galopago/compact-nfc/compact-nfc.kicad_pcb

## KiCad design compact-nfc.kicad_pcb (2026-01-25)

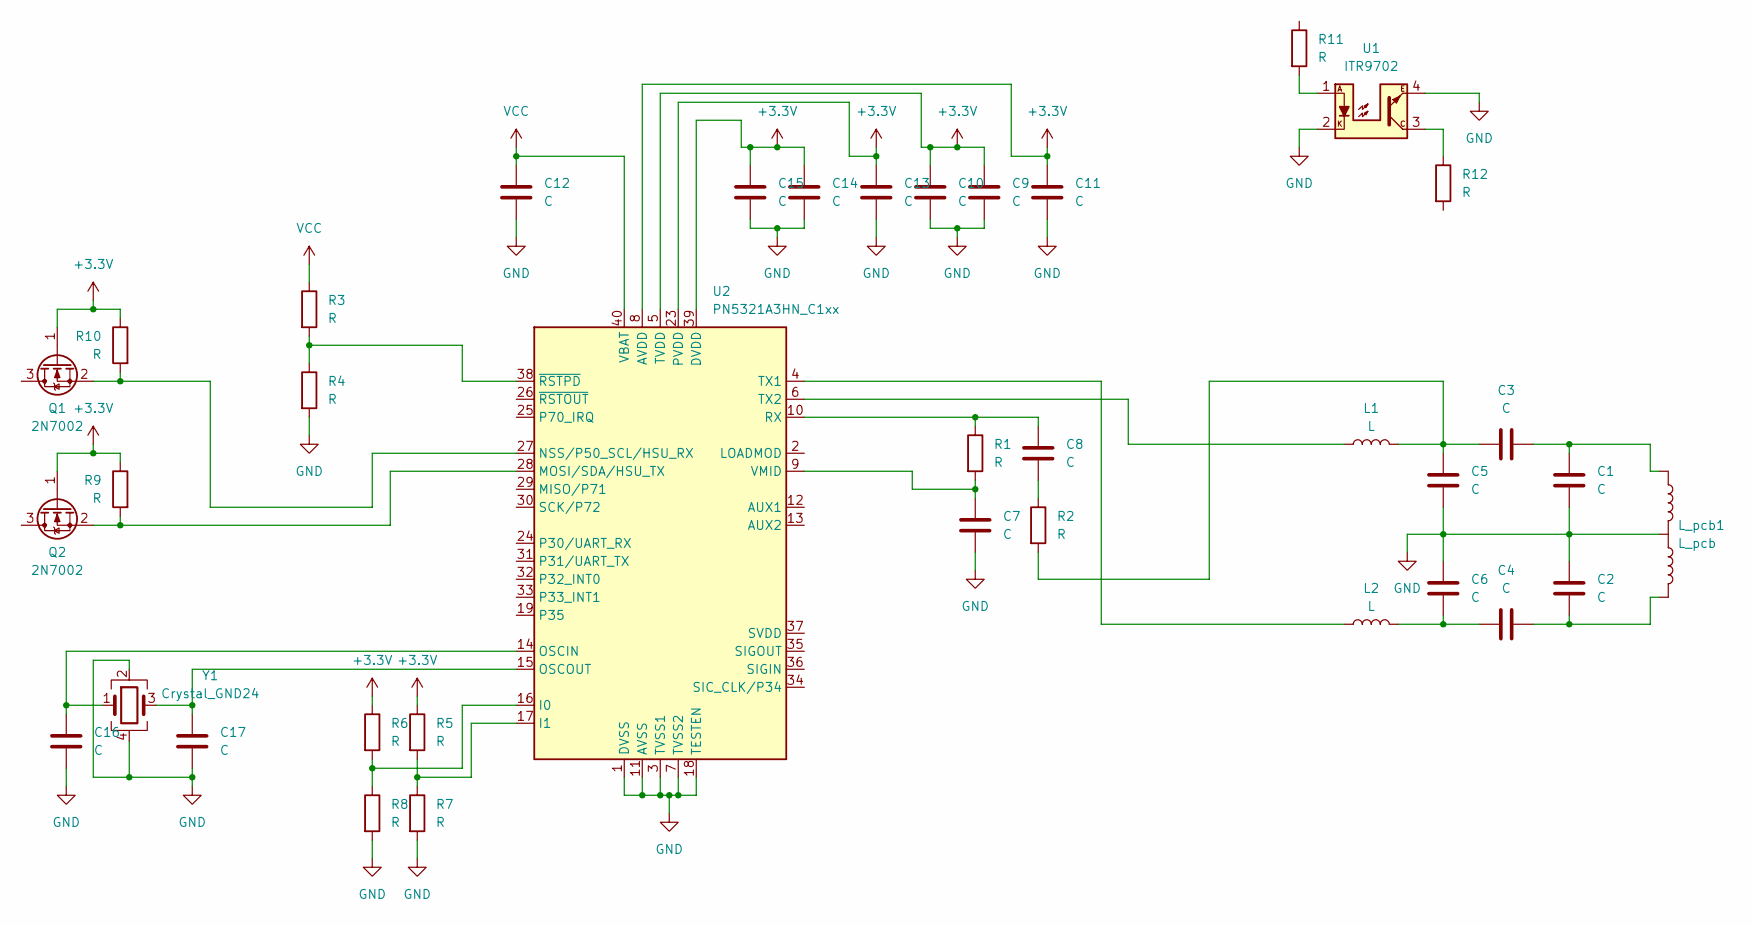
[picture p12: schematic compact-nfc.kicad_sch]

Parts:
C1, C2, C3, C4, C5, C6, C7, C8, C9, C10, C11, C12, C13, C14, C15, C16, C17: C; C_0805_2012Metric_Pad1.18x1.45mm_HandSolder
L1, L2: L; L_1206_3216Metric_Pad1.22x1.90mm_HandSolder
L_pcb1: L_pcb; L_NFC_PCB
Q1, Q2: 2N7002; SOT-23
R1, R2, R3, R4, R5, R6, R7, R8, R9, R10, R11, R12: R; R_0805_2012Metric_Pad1.20x1.40mm_HandSolder
U1: ITR9702; Everlight_ITR9702
U2: PN5321A3HN_C1xx; HVQFN-40-1EP_6x6mm_P0.5mm_EP4.1x4.1mm
Y1: Crystal_GND24; Crystal_SMD_3225-4Pin_3.2x2.5mm_HandSoldering

Connections:
+3.3V: C9.1, C10.1, C11.1, C13.1, C14.1, C15.1, Q1.1 (G), Q2.1 (G), R5.1, R6.1, R9.1, R10.1, U2.5 (TVDD), U2.8 (AVDD), U2.23 (PVDD), U2.39 (DVDD)
GND: C1.2, C2.1, C5.2, C6.1, C7.1, C9.2, C10.2, C11.2, C12.2, C13.2, C14.2, C15.2, C16.1, C17.1, L_pcb1.2, R4.2, R7.2, R8.2, U1.2, U1.4, U2.1 (DVSS), U2.3 (TVSS1), U2.7 (TVSS2), U2.11 (AVSS), U2.18 (TESTEN), U2.41 (AVSS), Y1.2, Y1.4
unnamed: C1.1, C3.2, L_pcb1.1
unnamed: C2.2, C4.2, L_pcb1.3
unnamed: C3.1, C5.1, L1.2, R2.2
unnamed: C4.1, C6.2, L2.2
unnamed: C8.1, R2.1
unnamed: Q1.2 (S), R10.2, U2.27 (NSS/P50_SCL/HSU_RX)
unnamed: Q2.2 (S), R9.2, U2.28 (MOSI/SDA/HSU_TX)
unnamed: R11.2, U1.1
unnamed: R12.1, U1.3
unnamed: R6.2, R8.1, U2.16 (I0)
unnamed: R5.2, R7.1, U2.17 (I1)
unnamed: C16.2, U2.14 (OSCIN), Y1.1
unnamed: C17.2, U2.15 (OSCOUT), Y1.3
unnamed: C8.2, R1.1, U2.10 (RX)
unnamed: L2.1, U2.4 (TX1)
unnamed: L1.1, U2.6 (TX2)
unnamed: C7.2, R1.2, U2.9 (VMID)
unnamed: R3.2, R4.1, U2.38 (~RSTPD)
VCC: C12.1, R3.1, U2.40 (VBAT)

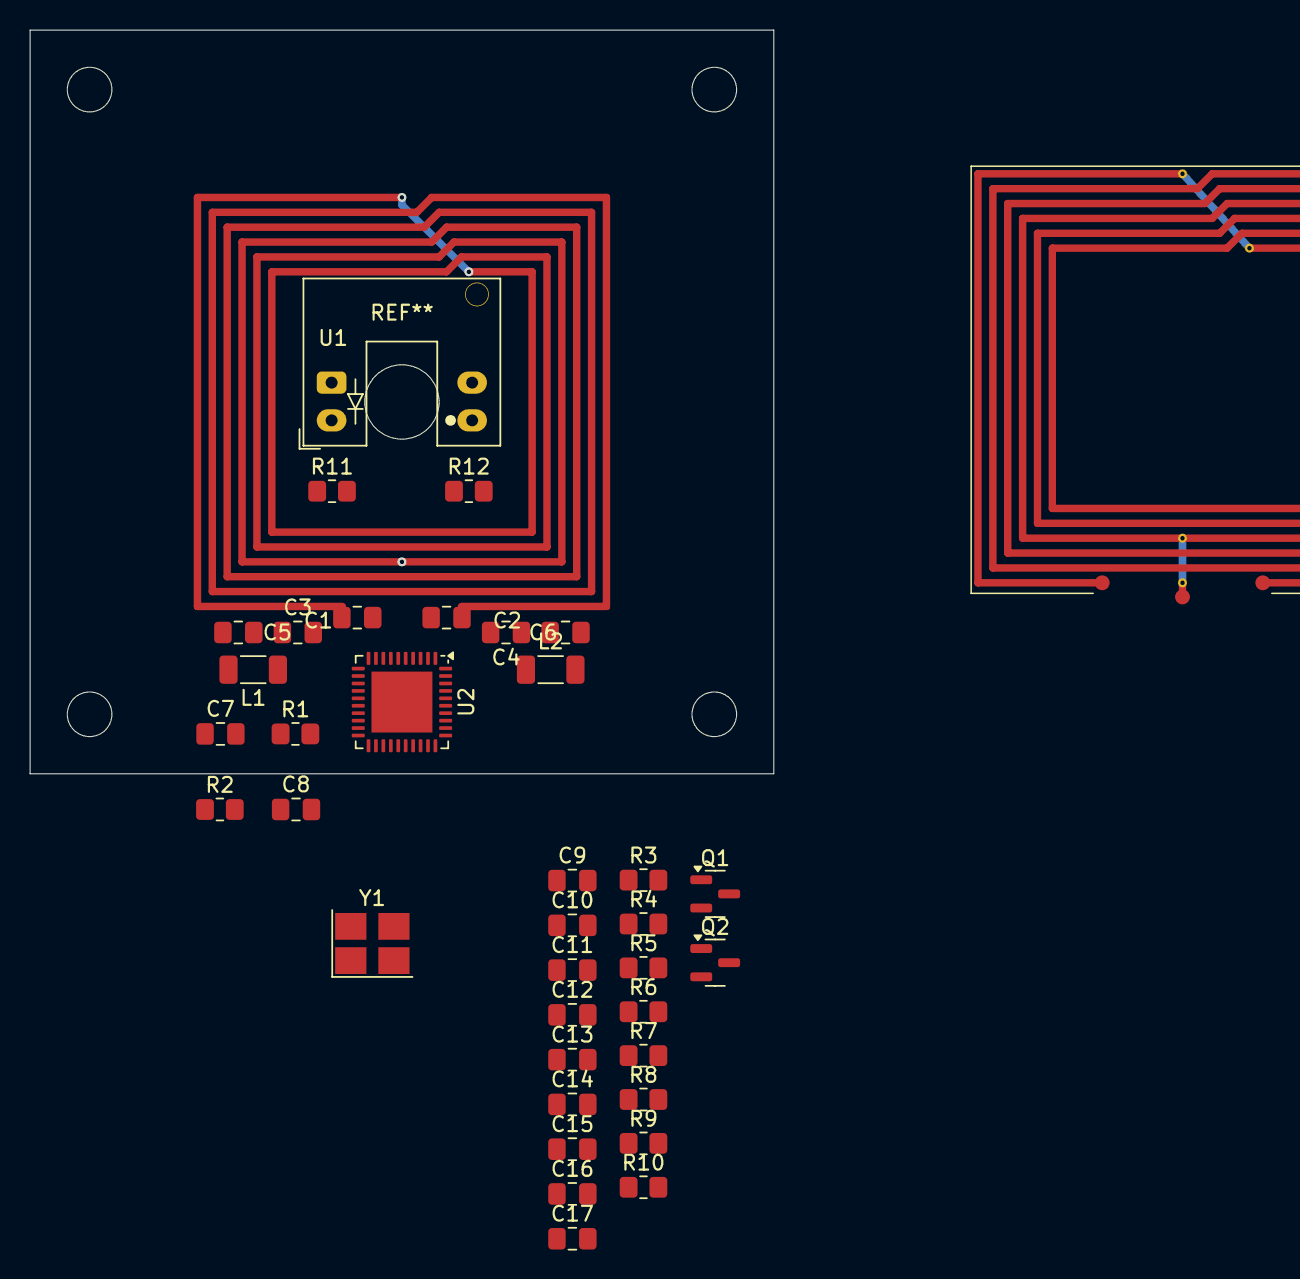
[picture p13: board compact-nfc.kicad_pcb from above]

Board: 2 copper layers, 50.0 x 50.0 mm, 37 parts (0 on the bottom side), 21 nets.
