galopago/compact-nfc/(commit log)

2026-01-06 Initial commit: KiCad project files
    [compact-nfc.kicad_pcb, compact-nfc.kicad_sch]
2026-01-06 Add infrared barrier sensor component: footprint and schematic symbol
    [compact-nfc.kicad_pcb, compact-nfc.kicad_sch]
2026-01-14 Add NFC chip and coil patterns for PCB
    [compact-nfc.kicad_pcb, compact-nfc.kicad_sch]
2026-01-16 Add coupling components to NFC antenna
    [compact-nfc.kicad_pcb, compact-nfc.kicad_sch]
2026-01-22 Update optical sensor fixation pin
    - Modify Everlight ITR9702 footprint (Everlight_ITR9702.kicad_mod)
    - Update PCB layout and schematic accordingly
    [compact-nfc.kicad_pcb, compact-nfc.kicad_sch]
2026-01-23 Add more components from reference schematic
    [compact-nfc.kicad_pcb, compact-nfc.kicad_sch]
2026-01-24 Start coil construction on PCB
    [compact-nfc.kicad_pcb, compact-nfc.kicad_sch]
2026-01-25 Add coil as PCB library component
    - Add L_NFC_PCB footprint (Inductor_PCB.pretty)
    - Add coil_pcb symbol
    - Update fp-lib-table and sym-lib-table
    - Update PCB and schematic with coil placement
    [compact-nfc.kicad_pcb, compact-nfc.kicad_sch]
